Lemood/Lemood.github.io/img/screenshot1.png

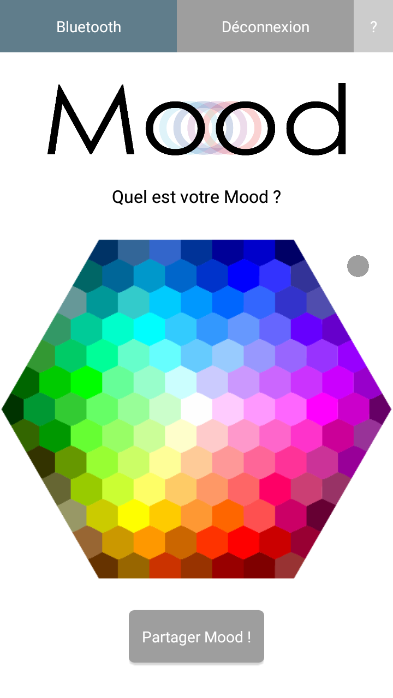
img/screenshot1.png
