Lemood/Lemood.github.io/README.md

# Lemood.github.io
Mood: presentation du projet
