Lemood/Lemood.github.io/files/pdf/T_laser.pdf

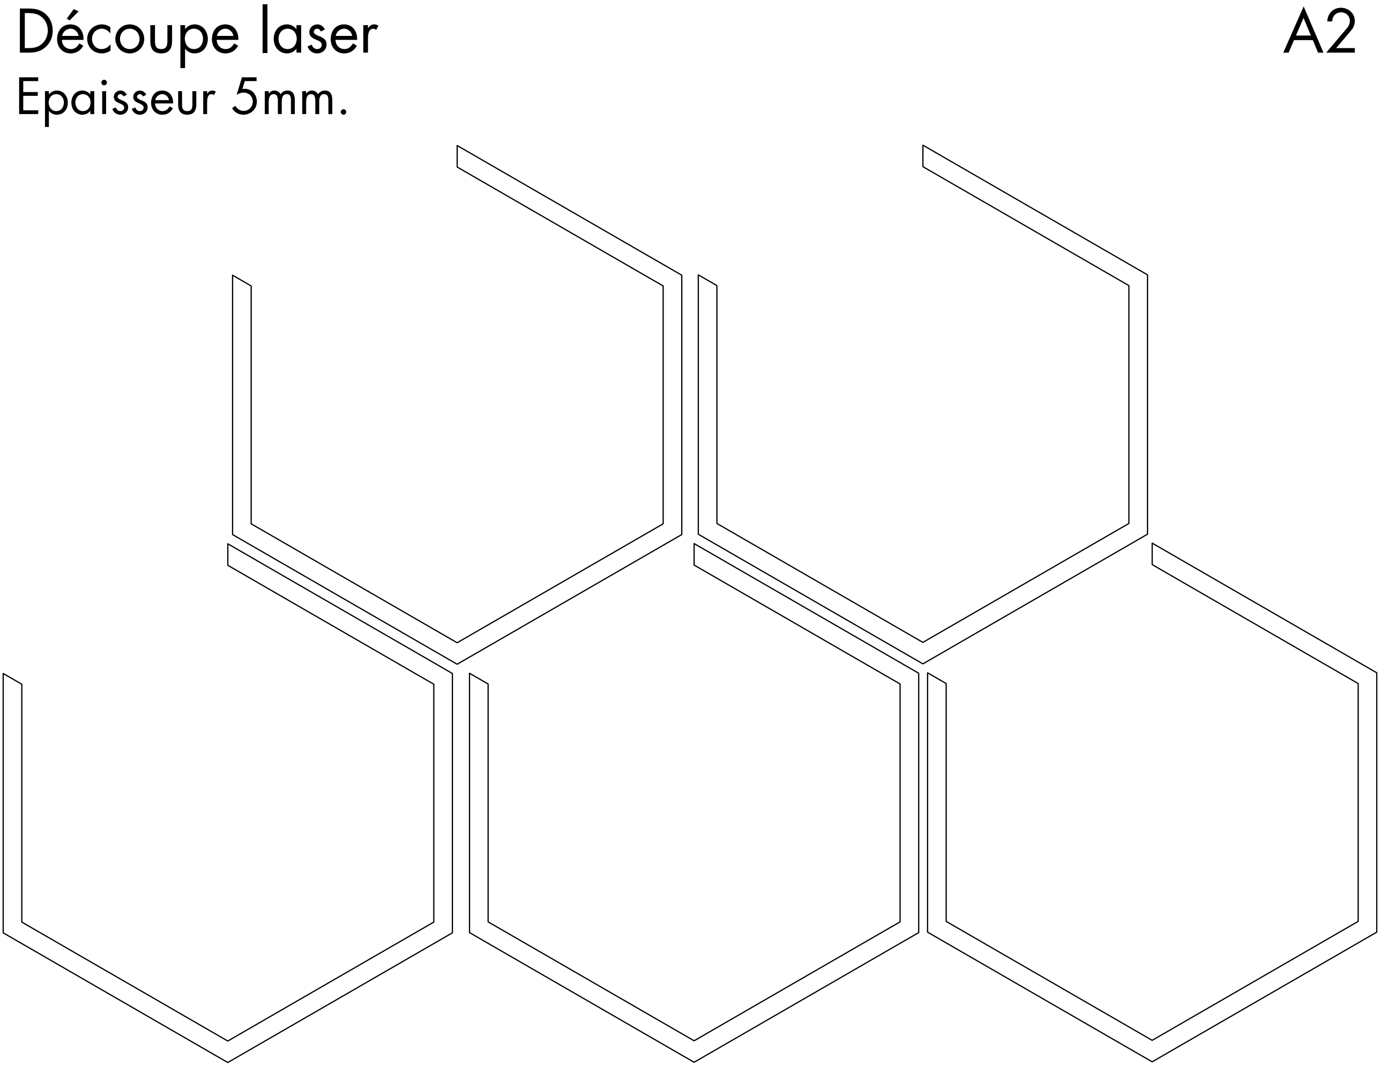
[picture p27: figure]
Découpe laser; Epaisseur 5mm.
