Lemood/Lemood.github.io/files/pdf/liste_elements.pdf

Arduino-nano

Module bluetooth hc 05

Led RGB avec resistance

Batterie externe (type batterie externe pour téléphone)

2 paires de 4 fils Dupont

Un cable USB à Micro-USB

### Liste éléments
