Lemood/Lemood.github.io/files/pdf/t_cnc.pdf

A2
Epaisseur 5mm. min.

### Découpe CNC

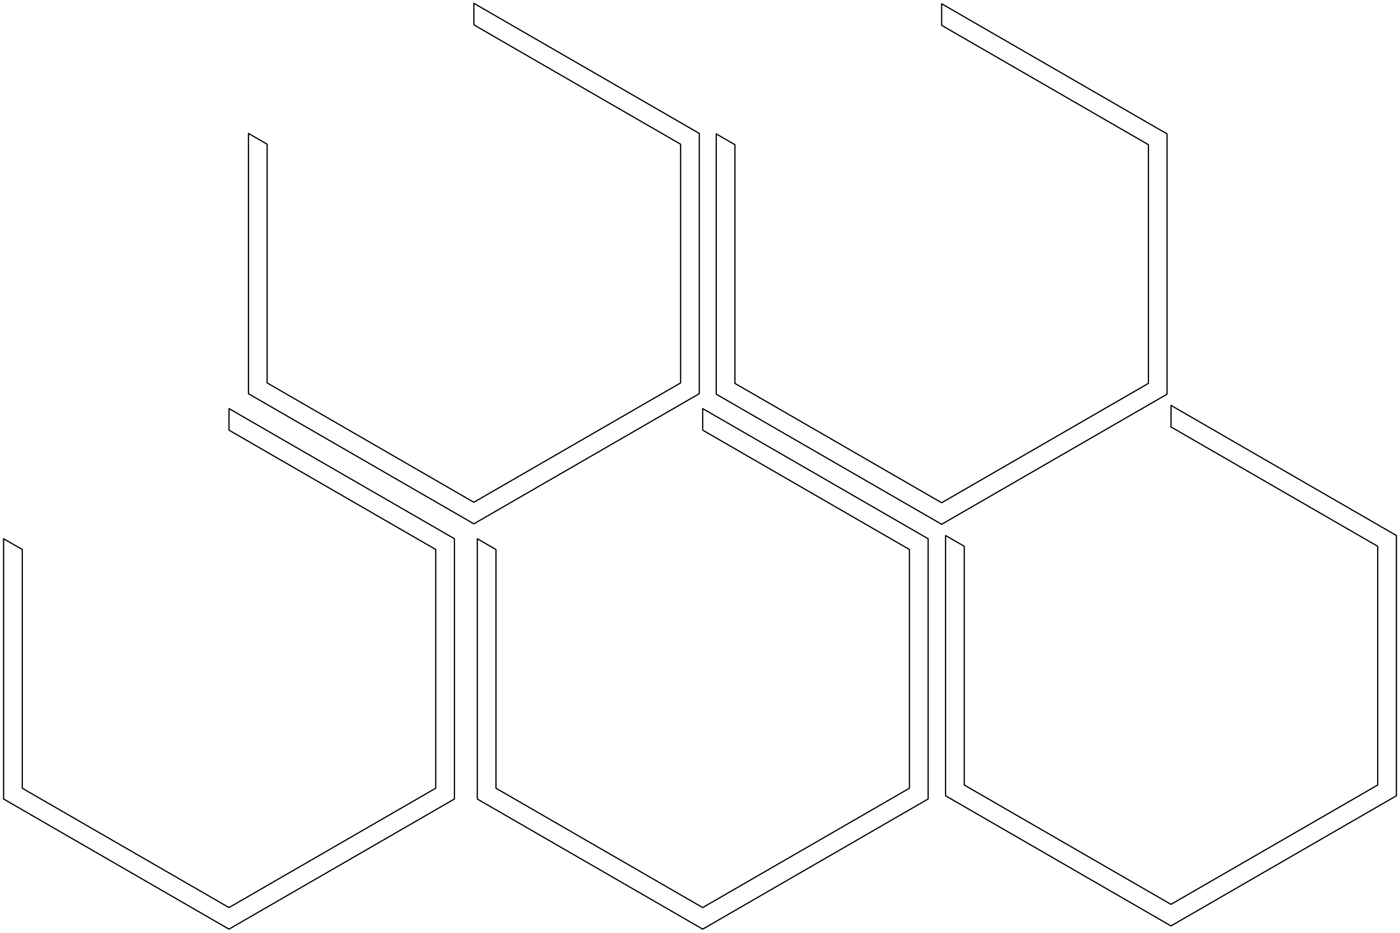
[picture p28: figure]
