Lemood/Lemood.github.io/img/01.png

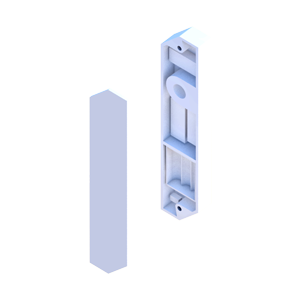
img/01.png
