Lemood/Lemood.github.io/img/02.png

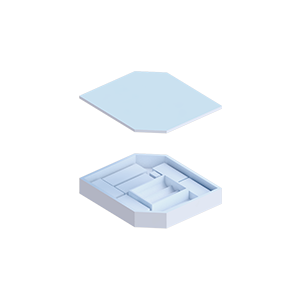
img/02.png
