Lemood/Lemood.github.io/img/03.png

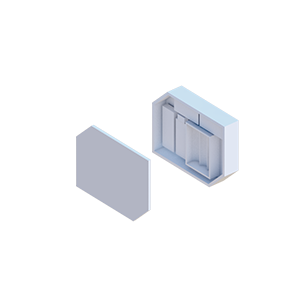
img/03.png
