Lemood/Lemood.github.io/img/10.png

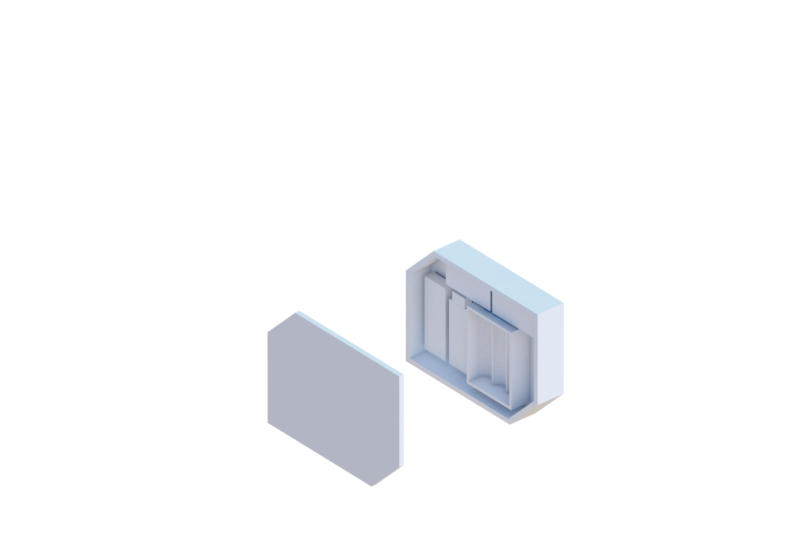
img/10.png
