Lemood/Lemood.github.io/img/11.png

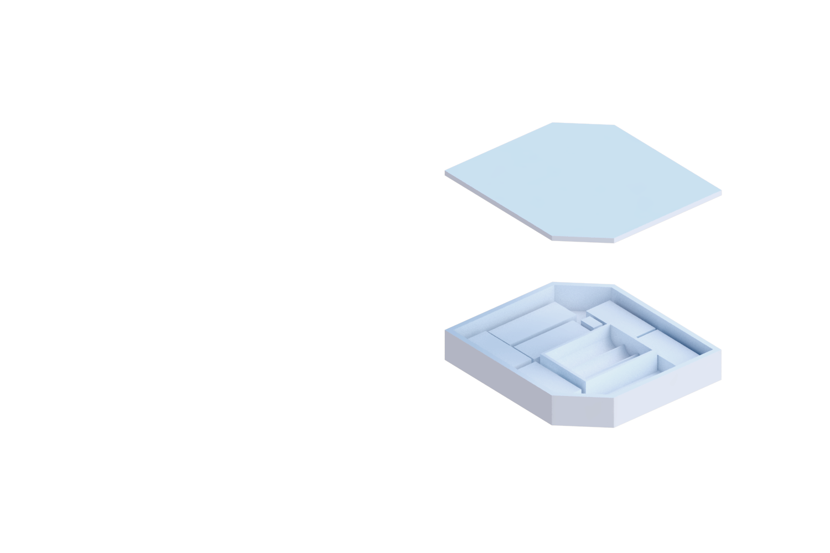
img/11.png
