Lemood/Lemood.github.io/img/066.png

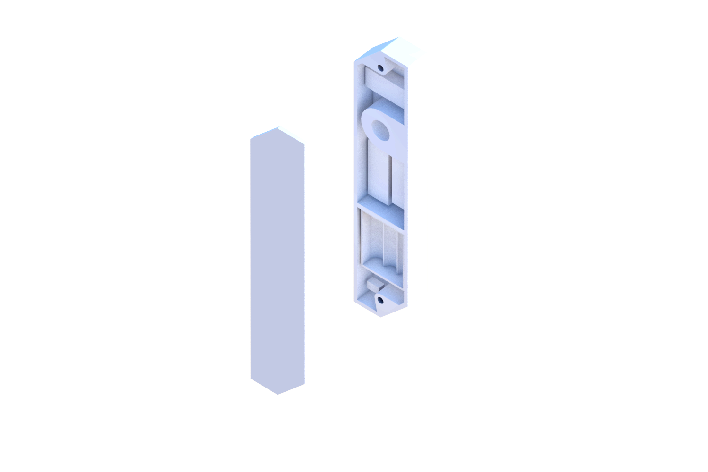
img/066.png
