Lemood/Lemood.github.io/img/mood_aia_t.png

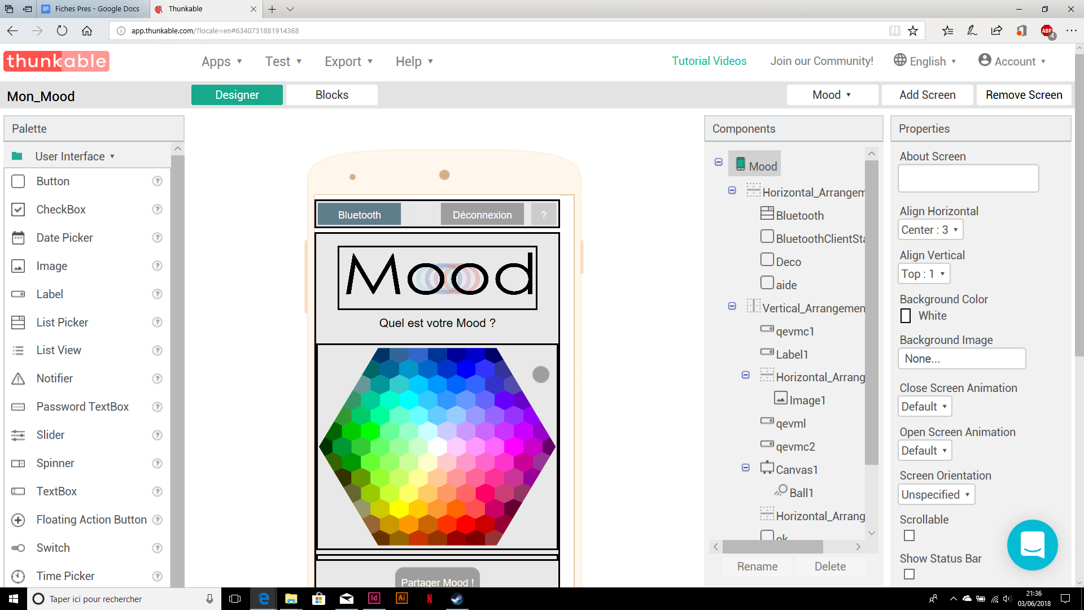
img/mood_aia_t.png
