Lemood/Lemood.github.io/img/mood_elec_F-01.png

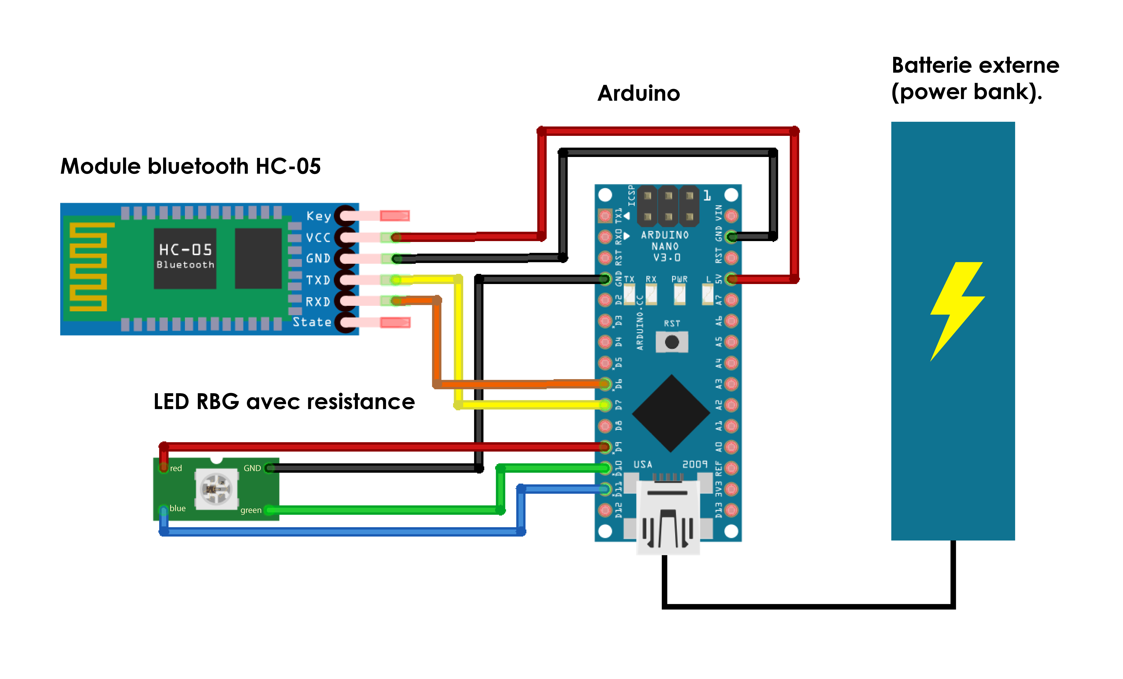
img/mood_elec_F-01.png
