Lemood/Lemood.github.io/img/mood_ino_t.png

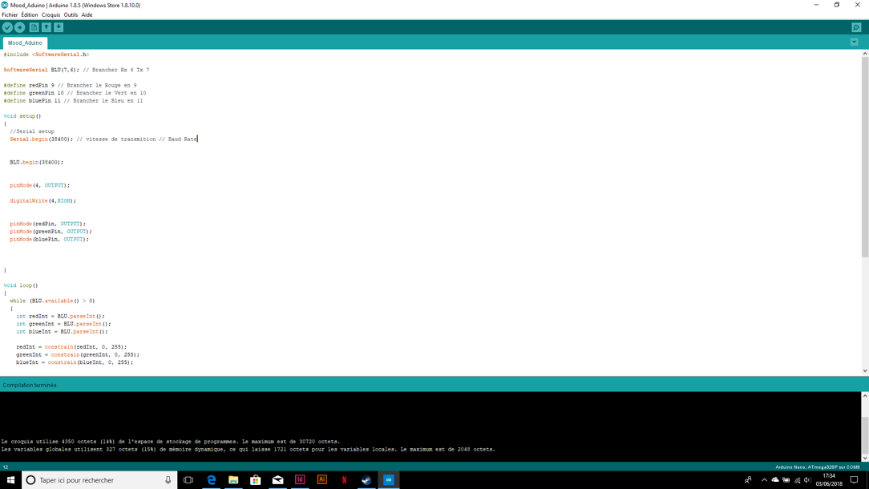
img/mood_ino_t.png
