Lemood/Lemood.github.io/img/t-scie.png

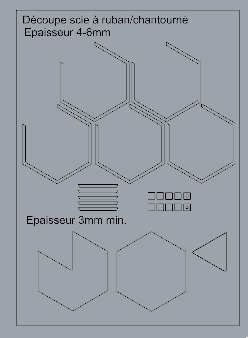
img/t-scie.png
