Lemood/Lemood.github.io/img/t_cnc.png

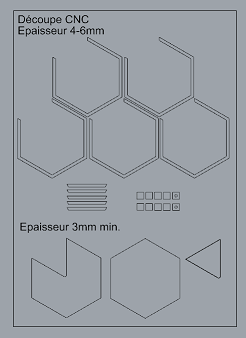
img/t_cnc.png
