Lemood/Lemood.github.io/img/t_code.png

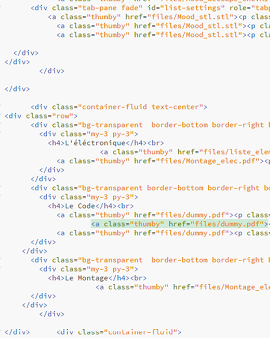
img/t_code.png
