Lemood/Lemood.github.io/img/t_imp3d.png

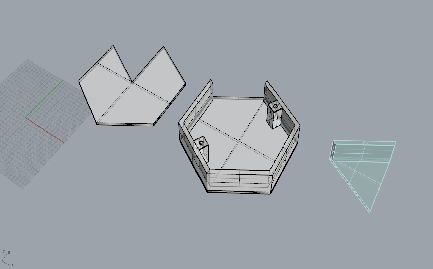
img/t_imp3d.png
