Lemood/Lemood.github.io/img/t_laser.png

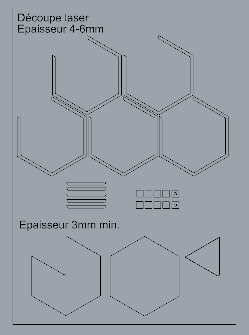
img/t_laser.png
