Lemood/Lemood.github.io/img/t_list.png

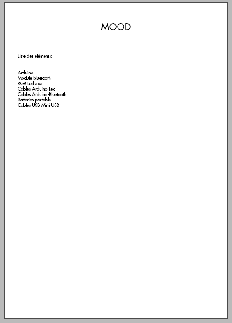
img/t_list.png
