Lemood/Lemood.github.io/img/tuto.png

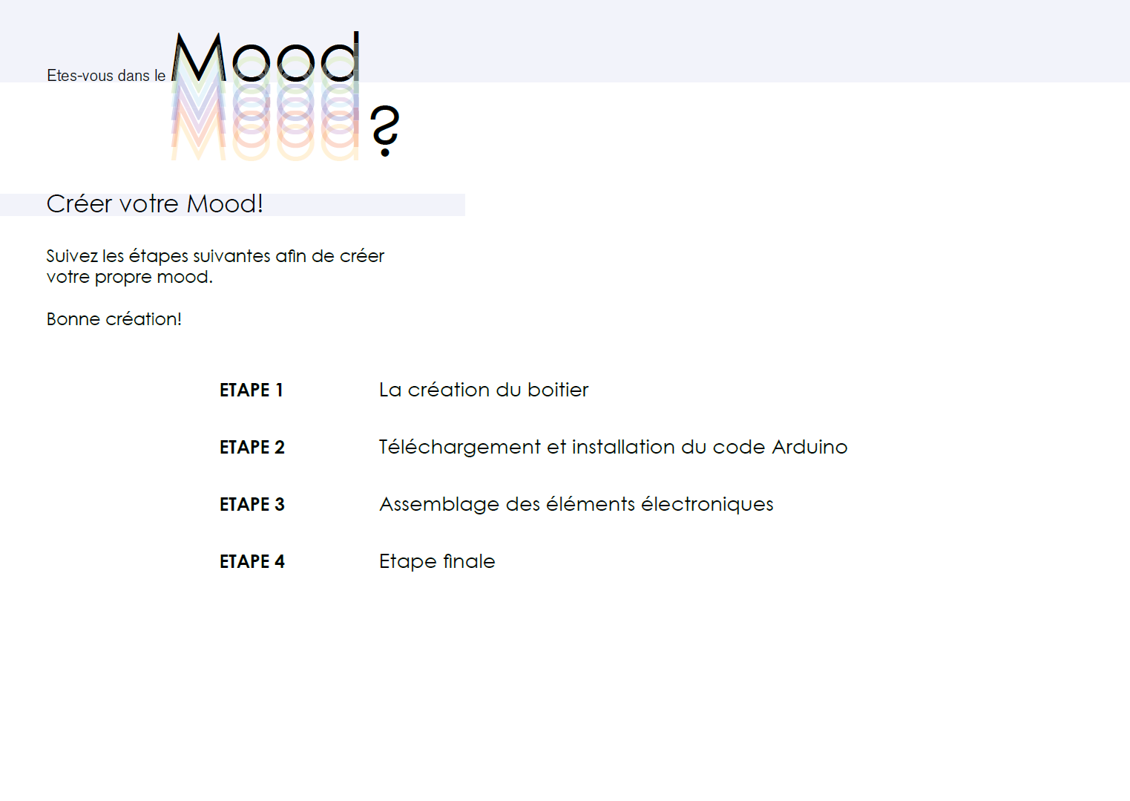
img/tuto.png
