Lemood/Lemood.github.io/files/3d/Mood_stl.stl

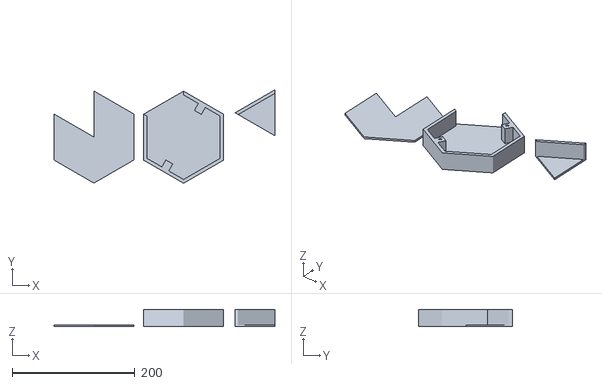
[picture p45: CAD file, 2018-06-01]
files/3d/Mood_stl.stl
360.1 x 152.4 x 28.0
