Lemood/Lemood.github.io/files/dxf/T_scie.dxf

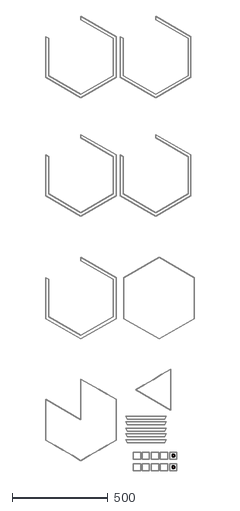
[picture p46: CAD file, 2018-06-02]
files/dxf/T_scie.dxf
776.5 x 2374.4
