Lemood/Lemood.github.io/files/dxf/T_cnc.dxf

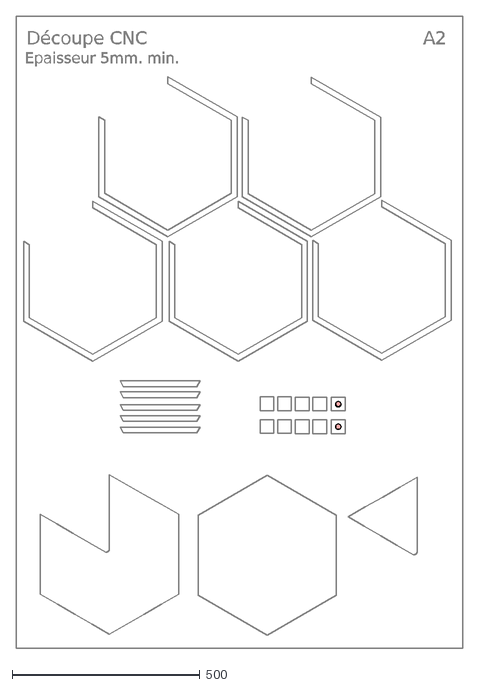
[picture p47: CAD file, 2018-06-02]
files/dxf/T_cnc.dxf
A2
Epaisseur 5mm. min.
Découpe CNC
