Lemood/Lemood.github.io/files/dxf/T_laser.dxf

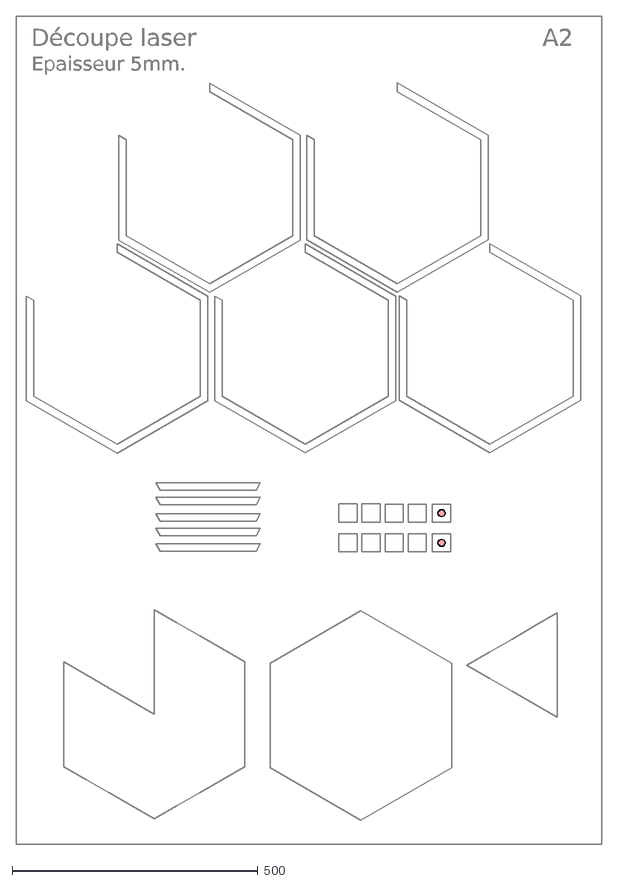
[picture p48: CAD file, 2018-06-02]
files/dxf/T_laser.dxf
Découpe laser
A2
Epaisseur 5mm.
