Lemood/Lemood.github.io/(list of files, cad)

Other CAD files:
files/3d/Mood_obj.obj
files/dwg/T_cnc.dwg
files/dwg/T_laser.dwg
files/dwg/T_scie.dwg
