Lemood/Lemood.github.io/files/pdf/Montage_elec.pdf

Plan de montage électronique:

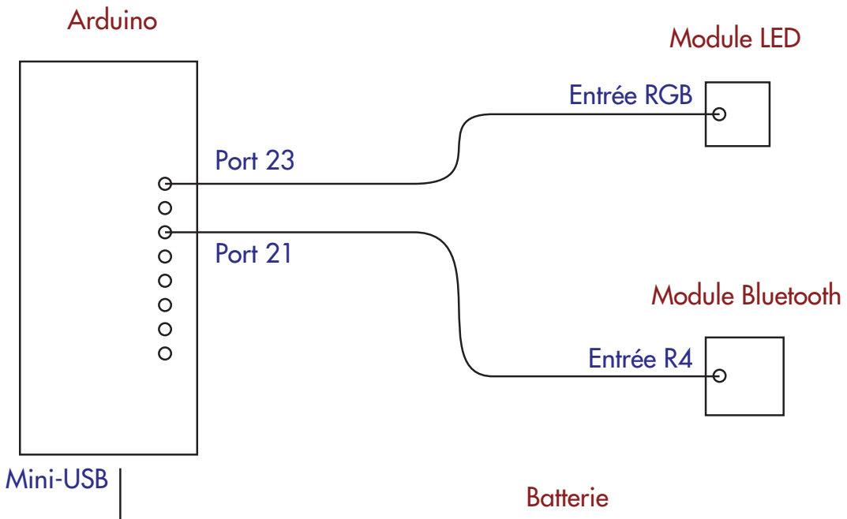
[picture p49: figure]
Module Bluetooth; Batterie; Arduino; Port 21; Port 23; Entrée RGB; Entrée R4; Mini-USB; Module LED

USB

# MOOD
