Lemood/Lemood.github.io/img/t_plan_montage2.png

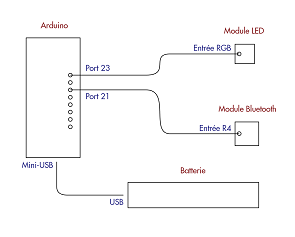
img/t_plan_montage2.png
